bytecod3/MusiQ-Player/assets/Graphical_Datasheet_Arduino_ProMini-5V_16MHzV2.png

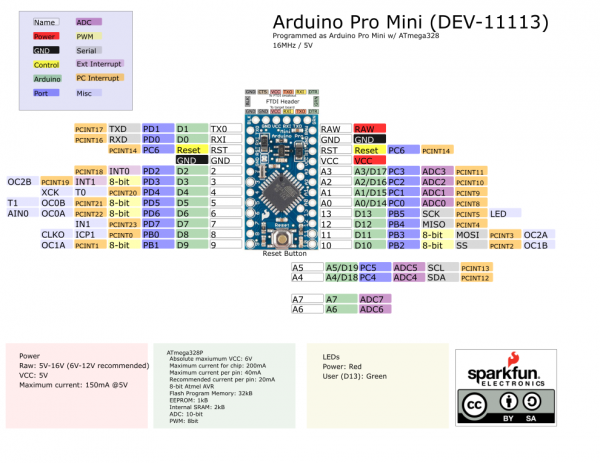
assets/Graphical_Datasheet_Arduino_ProMini-5V_16MHzV2.png
