bytecod3/MusiQ-Player/assets/images (3).png

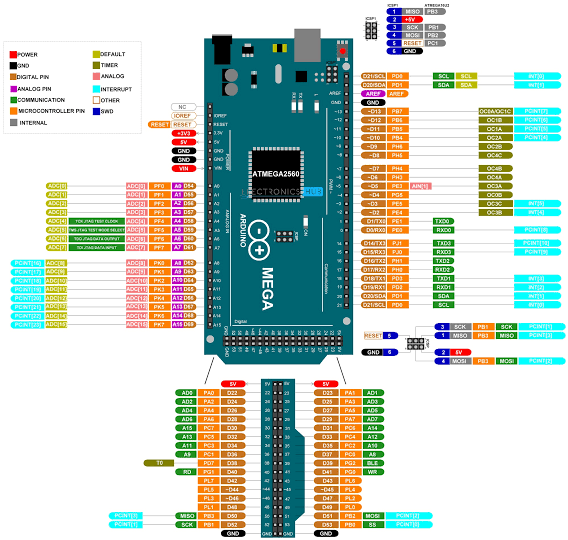
assets/images (3).png
