bytecod3/MusiQ-Player/assets/images (15).jpeg

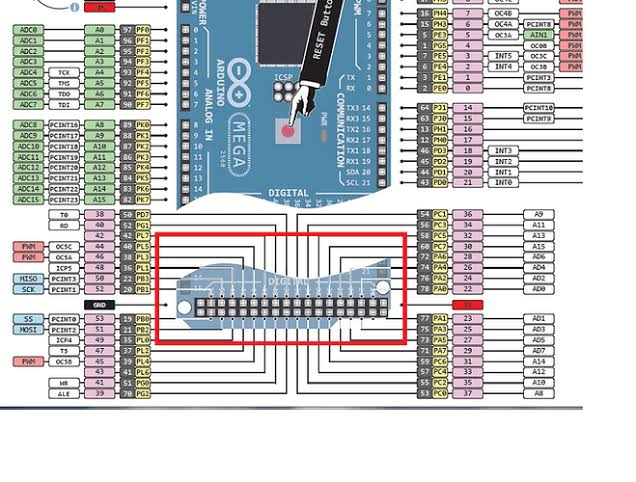
assets/images (15).jpeg
