bytecod3/MusiQ-Player/assets/sd-socket-specs.webp

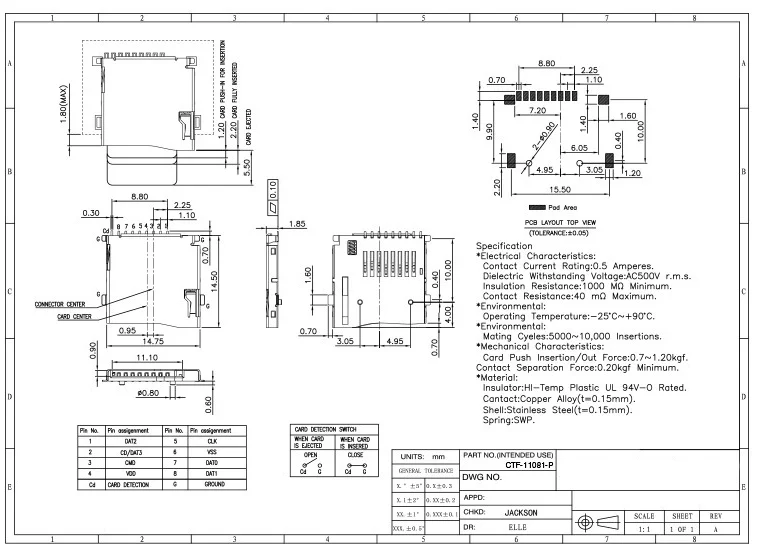
assets/sd-socket-specs.webp
