bytecod3/MusiQ-Player/images/home-gray.png

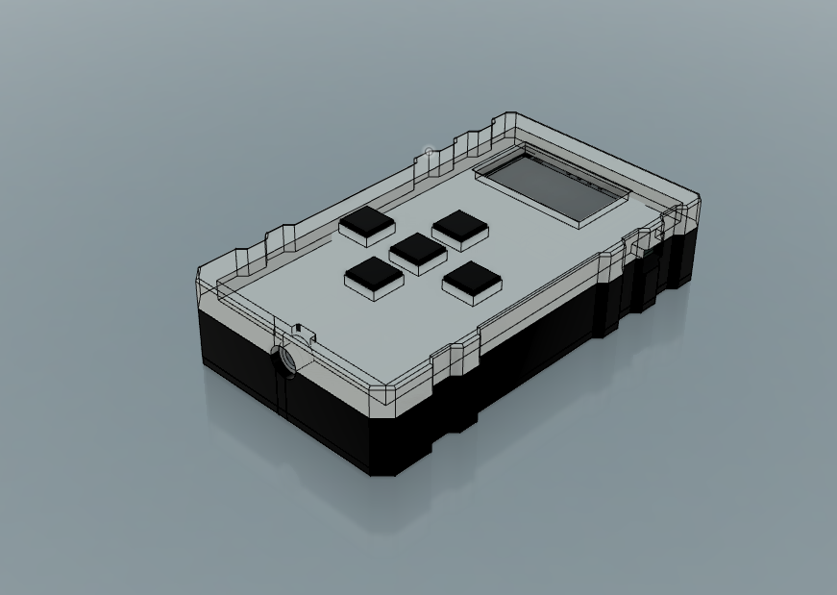
images/home-gray.png
