bytecod3/MusiQ-Player/images/top-raytraced.png

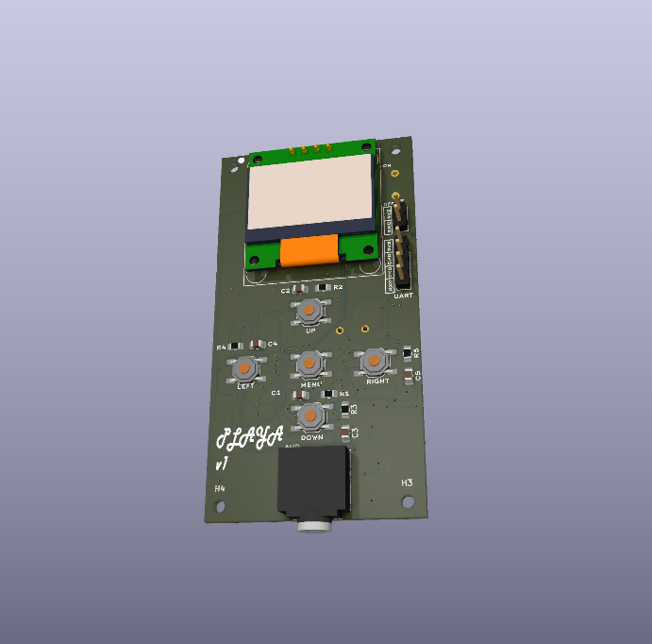
images/top-raytraced.png
