bytecod3/MusiQ-Player/hardware/playa-schematic-v1.pdf

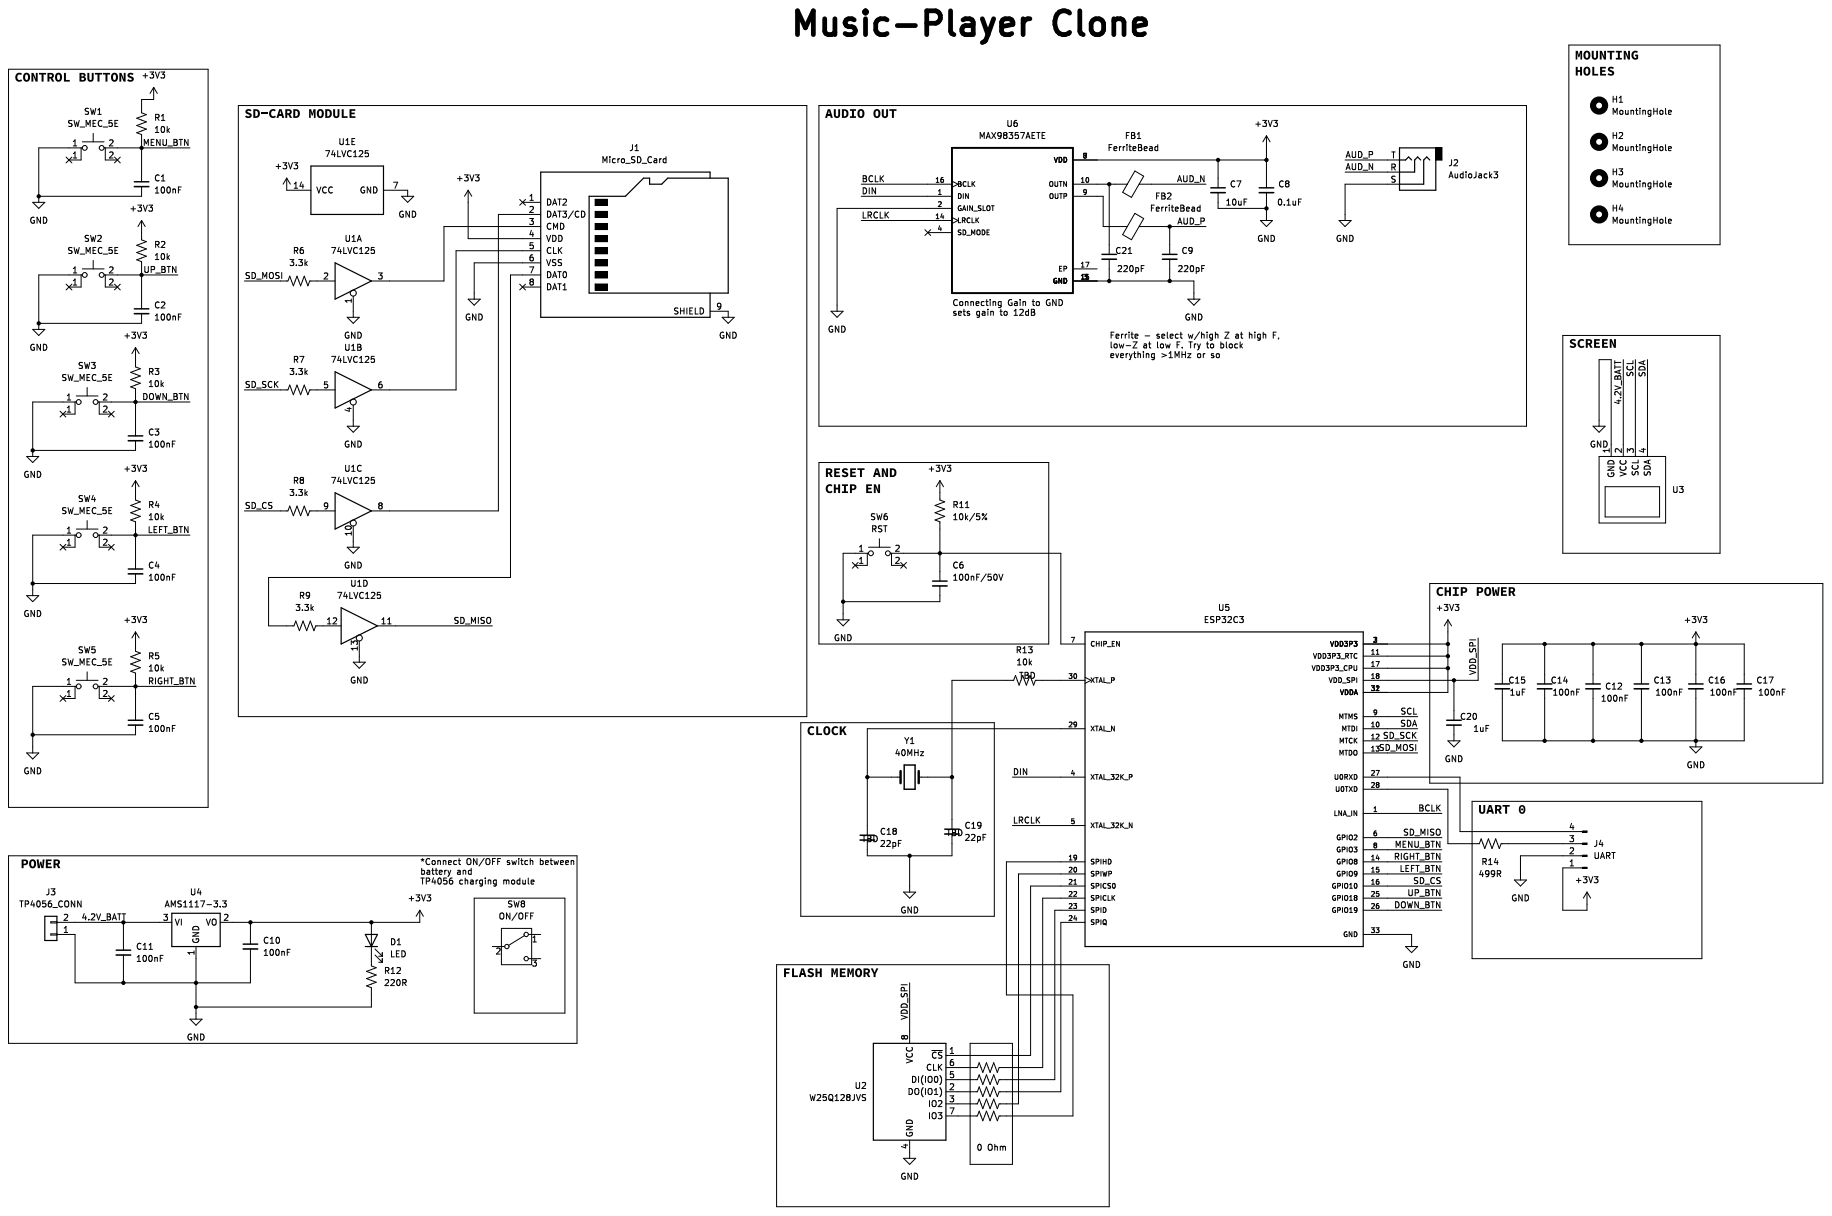
[picture p19: page 1]
