bytecod3/MusiQ-Player/hardware/musiq-player-hardware/musiq-player-hardware.kicad_pcb

## KiCad design hardware/musiq-player-hardware/musiq-player-hardware.kicad_pcb (2024-03-26)

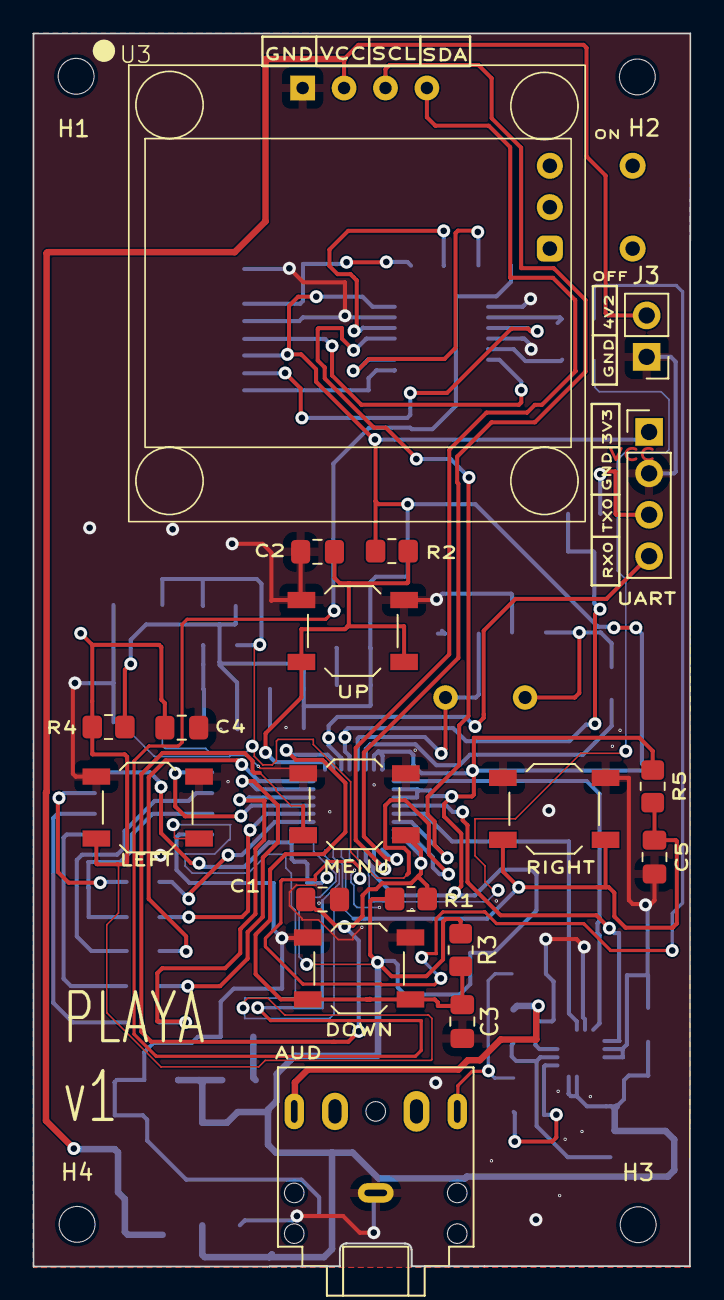
[picture p20: board musiq-player-hardware.kicad_pcb from above]

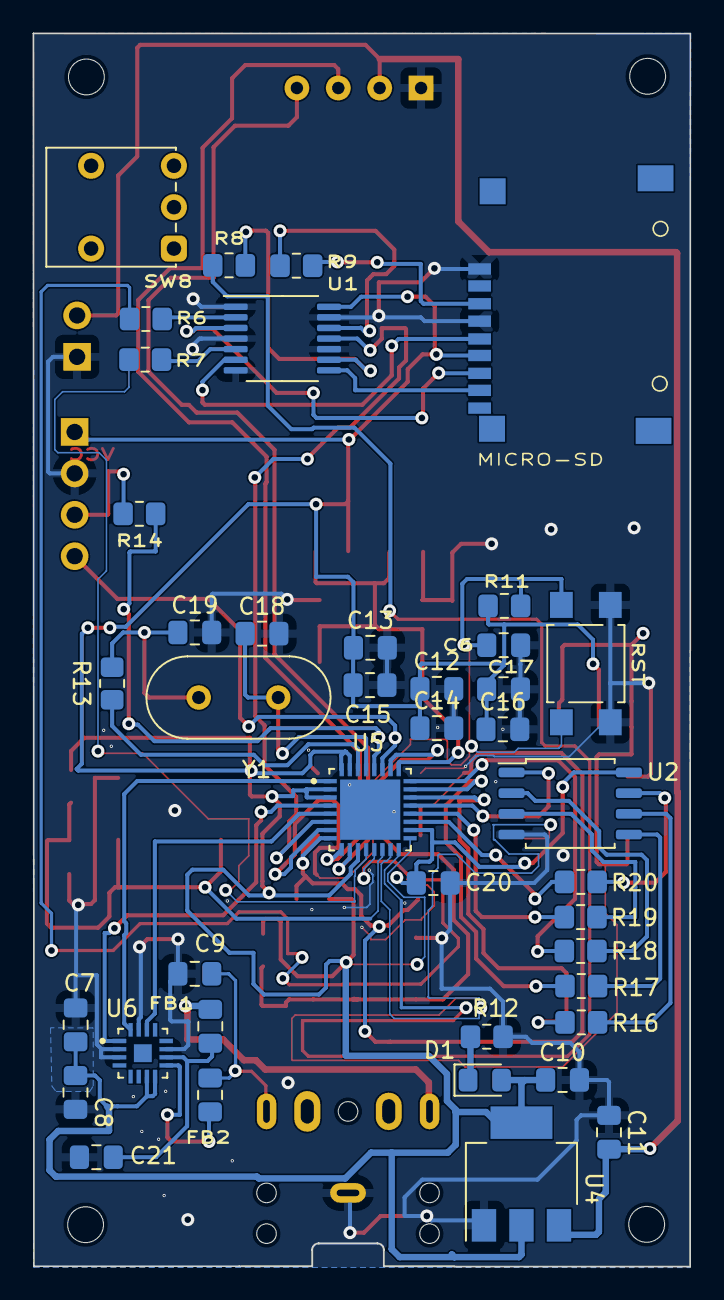
[picture p21: board musiq-player-hardware.kicad_pcb from below]

Board: 2 copper layers, 40.3 x 75.7 mm, 64 parts (41 on the bottom side), 49 nets.

Parts:
AUD: AudioJack3; Jack_3.5mm_CUI_SJ1-3525N_Horizontal
C1, C2, C3, C4, C5, C10, C11, C12, C13, C14, C16, C17: 100nF; C_0805_2012Metric_Pad1.18x1.45mm_HandSolder
C6: 100nF/50V; C_0805_2012Metric_Pad1.18x1.45mm_HandSolder
C7: 10uF; C_0805_2012Metric_Pad1.18x1.45mm_HandSolder
C8: 0.1uF; C_0805_2012Metric_Pad1.18x1.45mm_HandSolder
C9, C21: 220pF; C_0805_2012Metric_Pad1.18x1.45mm_HandSolder
C15, C20: 1uF; C_0805_2012Metric_Pad1.18x1.45mm_HandSolder
C18, C19: 22pF; C_0805_2012Metric_Pad1.18x1.45mm_HandSolder
D1: LED; LED_0805_2012Metric_Pad1.15x1.40mm_HandSolder
DOWN: SW_MEC_5E; SW_SPST_TL3342
FB1, FB2: FerriteBead; C_0805_2012Metric_Pad1.18x1.45mm_HandSolder
H1, H2, H3, H4: MountingHole; MountingHole_2.2mm_M2
J3: TP4056_CONN; PinHeader_1x02_P2.54mm_Vertical
LEFT: SW_MEC_5E; SW_SPST_TL3342
MENU: SW_MEC_5E; SW_SPST_TL3342
MICRO-SD: Micro_SD_Card; SD-CARD-Adapter-alibaba
R1, R2, R3, R4, R5, R13, R16, R17, R18, R19, R20: 10k; R_0805_2012Metric_Pad1.20x1.40mm_HandSolder
R6, R7, R8, R9: 3.3k; R_0805_2012Metric_Pad1.20x1.40mm_HandSolder
R11: 10k/5%; R_0805_2012Metric_Pad1.20x1.40mm_HandSolder
R12: 220R; R_0805_2012Metric_Pad1.20x1.40mm_HandSolder
R14: 499R; R_0805_2012Metric_Pad1.20x1.40mm_HandSolder
RIGHT: SW_MEC_5E; SW_SPST_TL3342
RST: RST; SW_SPST_TL3305A
SW8: ON/OFF; SW_Push_1P2T_Vertical_E-Switch_800UDP8P1A1M6
U1: 74LVC125; TSSOP-14_4.4x5mm_P0.65mm
U2: W25Q128JVS; SOIC-8_5.23x5.23mm_P1.27mm
U3: oled-ssd1306
U4: AMS1117-3.3; SOT-223-3_TabPin2
U5: ESP32C3; QFN32_5X5MM
U6: MAX98357AETE; QFN50P300X300X80-17N
UART: UART; PinHeader_1x04_P2.54mm_Vertical
UP: SW_MEC_5E; SW_SPST_TL3342
Y1: 40MHz; Crystal_HC49-U_Vertical

Connections:
+3V3: C7.1, C8.1, C10.1, C12.1, C13.1, C14.1, C15.1, C16.1, C17.1, D1.2 (A), MICRO-SD.4 (VDD), R1.1, R2.1, R3.1, R4.1, R5.1, R11.1, U1.14 (VCC), U4.2 (VO), U5.2 (VDD3P3), U5.3 (VDD3P3), U5.11 (VDD3P3_RTC), U5.17 (VDD3P3_CPU), U5.31 (VDDA), U5.32 (VDDA), U6.7 (VDD), U6.8 (VDD), UART.1
/4.2V_BATT: C11.1, J3.2, U3.2 (VCC), U4.3 (VI)
/AUD_N: AUD.R, FB1.2
/AUD_P: AUD.T, C9.1, FB2.2
/BCLK: U5.1 (LNA_IN), U6.16 (BCLK)
/DIN: U5.4 (XTAL_32K_P), U6.1 (DIN)
/DOWN_BTN: C3.1, DOWN.2 (A), R3.2, U5.26 (GPIO19)
/LEFT_BTN: C4.1, LEFT.2 (A), R4.2, U5.15 (GPIO9)
/LRCLK: U5.5 (XTAL_32K_N), U6.14 (LRCLK)
/MENU_BTN: C1.1, MENU.2 (A), R1.2, U5.8 (GPIO3)
/RIGHT_BTN: C5.1, R5.2, RIGHT.2 (A), U5.14 (GPIO8)
/SCL: U3.3 (SCL), U5.9 (MTMS)
/SDA: U3.4 (SDA), U5.10 (MTDI)
/SD_CS: R8.1, U5.16 (GPIO10)
/SD_MISO: U1.11, U5.6 (GPIO2)
/SD_MOSI: R6.1, U5.13 (MTDO)
/SD_SCK: R7.1, U5.12 (MTCK)
/UP_BTN: C2.1, R2.2, U5.25 (GPIO18), UP.2 (A)
/VDD_SPI: C20.1, U2.8 (VCC), U5.18 (VDD_SPI)
GND: AUD.S, C1.2, C2.2, C3.2, C4.2, C5.2, C6.2, C7.2, C8.2, C9.2, C10.2, C11.2, C12.2, C13.2, C14.2, C15.2, C16.2, C17.2, C18.2, C19.2, C20.2, C21.2, DOWN.1, J3.1, LEFT.1, MENU.1, MICRO-SD.6 (VSS), MICRO-SD.9 (SHIELD), R12.2, RIGHT.1, RST.1, U1.1, U1.4, U1.7 (GND), U1.10, U1.13, U2.4 (GND), U3.1 (GND), U4.1 (GND), U5.33 (GND), U6.2 (GAIN_SLOT), U6.3 (GND), U6.11 (GND), U6.15 (GND), UART.2, UP.1
unnamed: C19.1, R13.1, Y1.2
unnamed: D1.1 (K), R12.1
unnamed: MICRO-SD.5 (CLK), U1.6
unnamed: MICRO-SD.3 (CMD), U1.3
unnamed: MICRO-SD.7 (DAT0), R9.1
unnamed: MICRO-SD.2 (DAT3/CD), U1.8
unnamed: R14.2, UART.3
unnamed: U5.27 (U0RXD), UART.4
unnamed: R6.2, U1.2
unnamed: R7.2, U1.5
unnamed: R8.2, U1.9
unnamed: R9.2, U1.12
unnamed: C6.1, R11.2, RST.2 (A), U5.7 (CHIP_EN)
unnamed: R16.1, U2.6 (CLK)
unnamed: R17.1, U2.5 (DI(IO0))
unnamed: R18.1, U2.2 (DO(IO1))
unnamed: R19.1, U2.3 (IO2)
unnamed: R20.1, U2.7 (IO3)
unnamed: U2.1 (~CS), U5.21 (SPICS0)
unnamed: R16.2, U5.22 (SPICLK)
unnamed: R17.2, U5.23 (SPID)
unnamed: R20.2, U5.19 (SPIHD)
unnamed: R18.2, U5.24 (SPIQ)
unnamed: R19.2, U5.20 (SPIWP)
unnamed: R14.1, U5.28 (U0TXD)
unnamed: C18.1, U5.29 (XTAL_N), Y1.1
unnamed: R13.2, U5.30 (XTAL_P)
unnamed: C21.1, FB1.1, U6.10 (OUTN)
unnamed: FB2.1, U6.9 (OUTP)
