bytecod3/MusiQ-Player/code/src/state_machine.cpp

#include "state_machine.h"

/**
 * @brief check the current running state and make a transition if 
 * need be
*/
void checkState() {
    return;
}

/**
 * @brief helper function to help debugging the current and previous states
*/
char* getCurrentState(int state) {
    switch (state) {
    case States::HOME:
        return "HOME";
        break;

    case States::MENU:
        return "MENU";
        break;

    case States::PLAYING:
        return "PLAYING";
        break;

    case States::SELECTING_MUSIC:
        return "SELECTING_MUSIC";
        break;

    case States::VOLUME:
        return "VOLUME";
        break;

    case States::SETTINGS:
        return "SETTINGS";
        break;
    
    case States::SD_CARD_INFO:
        return "SD_CARD_INFO";
        break;

    case States::EQ:
        return "EQ";
        break;

    case States::ABOUT:
        return "ABOUT";
        break;
    
    default:
        return "UNDEFINED";
        break;
    }
}
