bytecod3/MusiQ-Player/code/include/bitmaps.h

#ifndef BITMAPS_H
#define BITMAPS_H

// 'about-icon', 16x16px
const unsigned char epd_bitmap_about_icon []  = {
	0x00, 0x00, 0x00, 0x00, 0x07, 0xe0, 0x08, 0x10, 0x10, 0x08, 0x10, 0x08, 0x10, 0x08, 0x10, 0x08, 
	0x00, 0x10, 0x01, 0xe0, 0x01, 0x80, 0x01, 0x80, 0x01, 0x80, 0x01, 0x80, 0x01, 0x80, 0x00, 0x00
};
// 'arrow-left', 16x16px
const unsigned char epd_bitmap_arrow_left []  = {
	0x00, 0xc0, 0x01, 0xc0, 0x03, 0xc0, 0x07, 0xc0, 0x1f, 0xc0, 0x3f, 0xc0, 0x7f, 0xc0, 0xff, 0xc0, 
	0x7f, 0xc0, 0x3f, 0xc0, 0x1f, 0xc0, 0x0f, 0xc0, 0x07, 0xc0, 0x03, 0xc0, 0x01, 0xc0, 0x00, 0xc0
};
// 'arrow-right', 16x16px
const unsigned char epd_bitmap_arrow_right []  = {
	0x01, 0x80, 0x01, 0xc0, 0x01, 0xe0, 0x01, 0xf0, 0x01, 0xf8, 0x01, 0xfc, 0x01, 0xfe, 0x01, 0xff, 
	0x01, 0xfe, 0x01, 0xfc, 0x01, 0xf8, 0x01, 0xf8, 0x01, 0xf0, 0x01, 0xe0, 0x01, 0xc0, 0x01, 0x80
};
// 'battery-icon', 16x8px
const unsigned char epd_bitmap_battery_icon []  = {
	0x00, 0x00, 0x7f, 0xf0, 0x7e, 0x08, 0x7f, 0x0c, 0x7f, 0x8c, 0x7f, 0xc8, 0x7f, 0xf0, 0x00, 0x00
};
// 'equalizer-icon', 16x16px
const unsigned char epd_bitmap_equalizer_icon []  = {
	0x00, 0x00, 0x00, 0x00, 0x20, 0x10, 0x00, 0x00, 0x20, 0x10, 0x20, 0x90, 0x20, 0x10, 0x24, 0x90, 
	0x20, 0x90, 0x24, 0x92, 0x24, 0x90, 0x24, 0x92, 0x24, 0x92, 0x24, 0x92, 0x00, 0x00, 0x00, 0x00
};
// 'icon_home', 16x16px
const unsigned char epd_bitmap_icon_home []  = {
	0x01, 0x00, 0x03, 0x80, 0x07, 0xc0, 0x0f, 0xe0, 0x1f, 0xf0, 0x3f, 0xf8, 0x7f, 0xfc, 0x0f, 0xe0, 
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
	0x00, 0x00, 0x80, 0x02, 0x00, 0x00, 0x00, 0x00, 0x40, 0x04, 0x00, 0x00, 0x00, 0x00, 0x20, 0x08, 
	0x00, 0x00, 0x00, 0x00, 0x10, 0x10, 0x00, 0x00, 0x00, 0x00, 0x08, 0x20, 0x00, 0x00, 0x00, 0x00, 
	0x07, 0xc0, 0x00, 0x00, 0x00, 0x00, 0x00, 0x00, 0x00, 0x00, 0x00, 0x00, 0x00, 0x00, 0x00, 0x00
};

// Array of all bitmaps for convenience. (Total bytes used to store images in PROGMEM = 752)
const int icons_array_length = 12;
const unsigned char* icons_array[icons_array_length] = {
    epd_bitmap_icon_home,
    epd_bitmap_icon_music,
    epd_bitmap_shuffle_icon,
    epd_bitmap_equalizer_icon,
    epd_bitmap_icon_settings,
	epd_bitmap_sd_card_info_icon,
	epd_bitmap_about_icon,
	epd_bitmap_music_file_icon,
	epd_bitmap_arrow_left,
	epd_bitmap_arrow_right,
	epd_bitmap_battery_icon,
	epd_bitmap_selected_item_background
};

#define music_icon_index 7

#endif
