bytecod3/MusiQ-Player/(commit log)

2024-02-27 adds function prototypes
2024-02-29 adds esp32 toolkit
2024-03-01 adds button class
2024-03-02 adds interrupt initialization
2024-03-03 fixes menu home selection
    [main.cpp, state_machine.h]
2024-03-03 FIXES: icons array indexing
    [bitmaps.h, main.cpp]
2024-03-07 adds playing screen animation
    [musiq-player-hardware.kicad_pcb, musiq-player-hardware.kicad_sch]
2024-03-07 FIXES: music list indexing issue
    [main.cpp]
2024-03-12 adds sd card module and esp-pico-d4
    [musiq-player-hardware.kicad_sch]
2024-03-12 adds on/off switch schematic
    [musiq-player-hardware.kicad_sch]
2024-03-15 adds esp32-c3 schematic
    [musiq-player-hardware.kicad_sch]
2024-03-20 complete schematic diagram
    [musiq-player-hardware.kicad_sch]
2024-03-26 adds complete PCB
    [musiq-player-hardware.kicad_pcb, musiq-player-hardware.kicad_sch]
2024-03-26 adds final PCB renders
    [musiq-player-hardware.kicad_pcb]
2024-03-26 adds 3D design files
    [musiq-player-hardware.kicad_pcb]
